Anish-Pun/PXLDIGITAL_GREEN_PROJECT_RESEARCH/Documentation/E220-900T22D.md

### Configuratie E220 (milan)

1. M0 & M1 : 3.3 V / HIGH				      ( Configuration / Sleep mode )
2. Wacht tot AUX uitgang = HIGH 			( E220 niet bezig )
3. Verzend @-command					( UART )
4. Wacht tot AUX = HIGH 			
5. Lees alles wat E220 beantwoordt		( UART )
6. Stap 3 OF exit config M0 & M1 : GND	( Transmission mode )
7. Wacht tot AUX = HIGH
8. Ontvang / Verzend LoRa berichten …

Codevoorbeeld van receiver bevindt zich in: Receiver/reset_config_pi5/config+reset.py
