Anish-Pun/PXLDIGITAL_GREEN_PROJECT_RESEARCH/Afbeeldingen/Sender_Connections.jpg

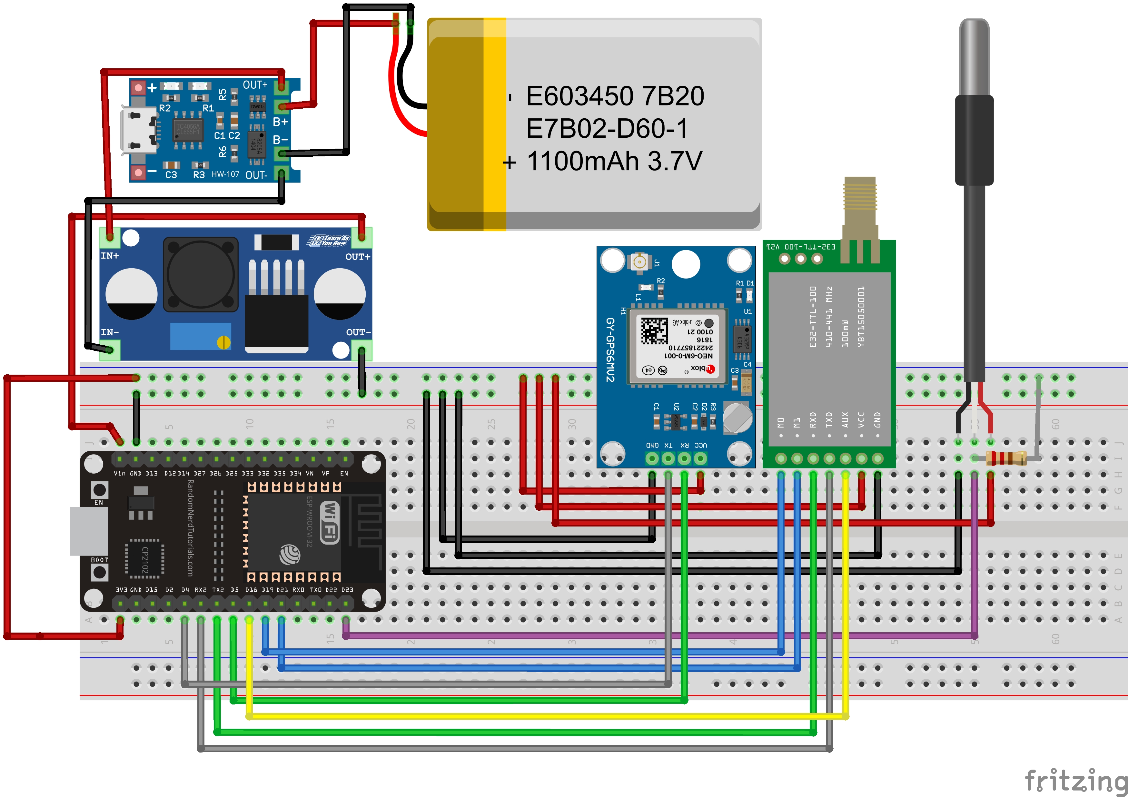
Afbeeldingen/Sender_Connections.jpg
