Anish-Pun/PXLDIGITAL_GREEN_PROJECT_RESEARCH/GPIO's/ESP32_20251021_100118.jpg

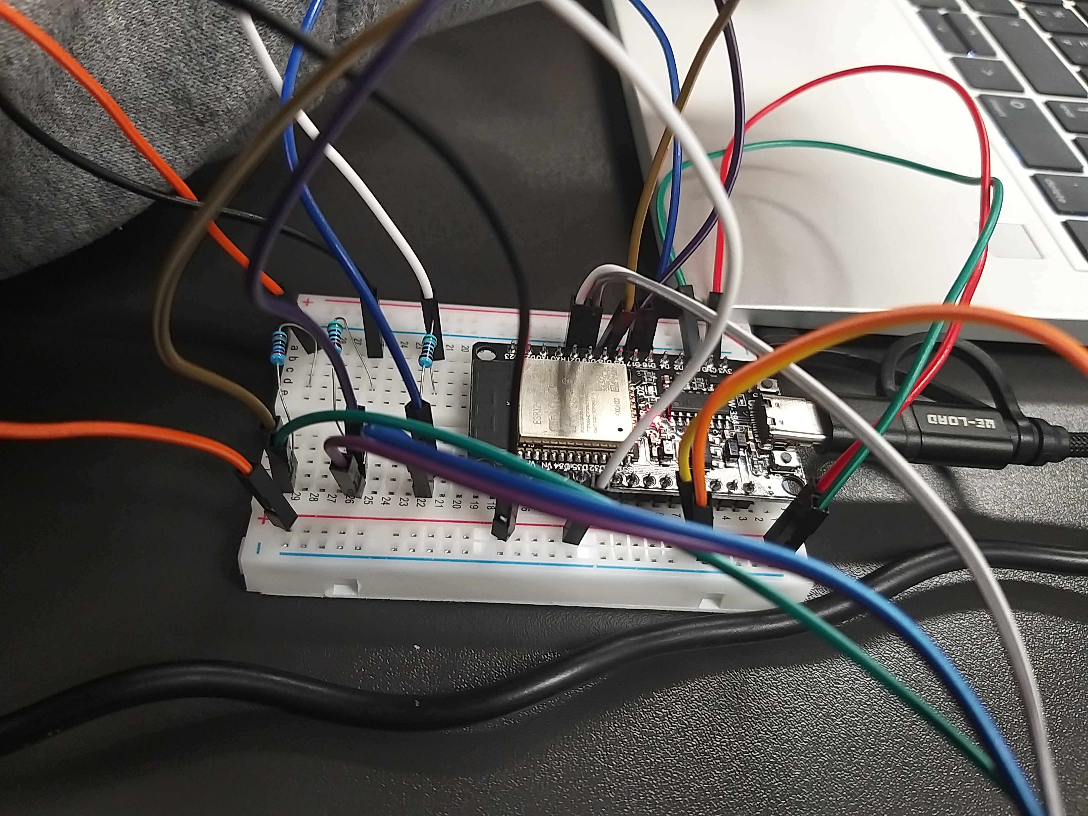
GPIO's/ESP32_20251021_100118.jpg
