Anish-Pun/PXLDIGITAL_GREEN_PROJECT_RESEARCH/GPIO's/gpio-raspberry-pi-4-3-3000036624.png

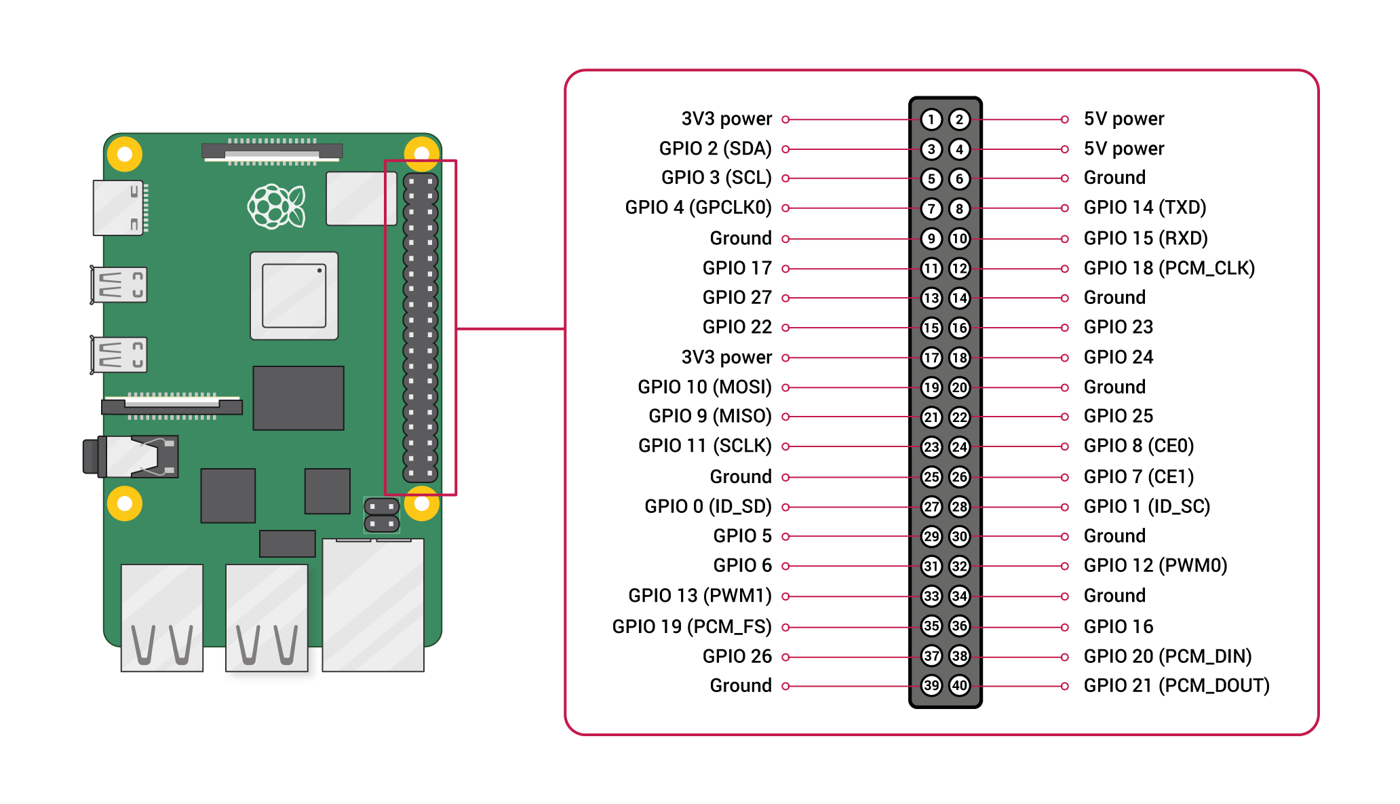
GPIO's/gpio-raspberry-pi-4-3-3000036624.png
