Anish-Pun/PXLDIGITAL_GREEN_PROJECT_RESEARCH/Receiver/reset_config_pi5/20251029_11h25m25s_grim.png

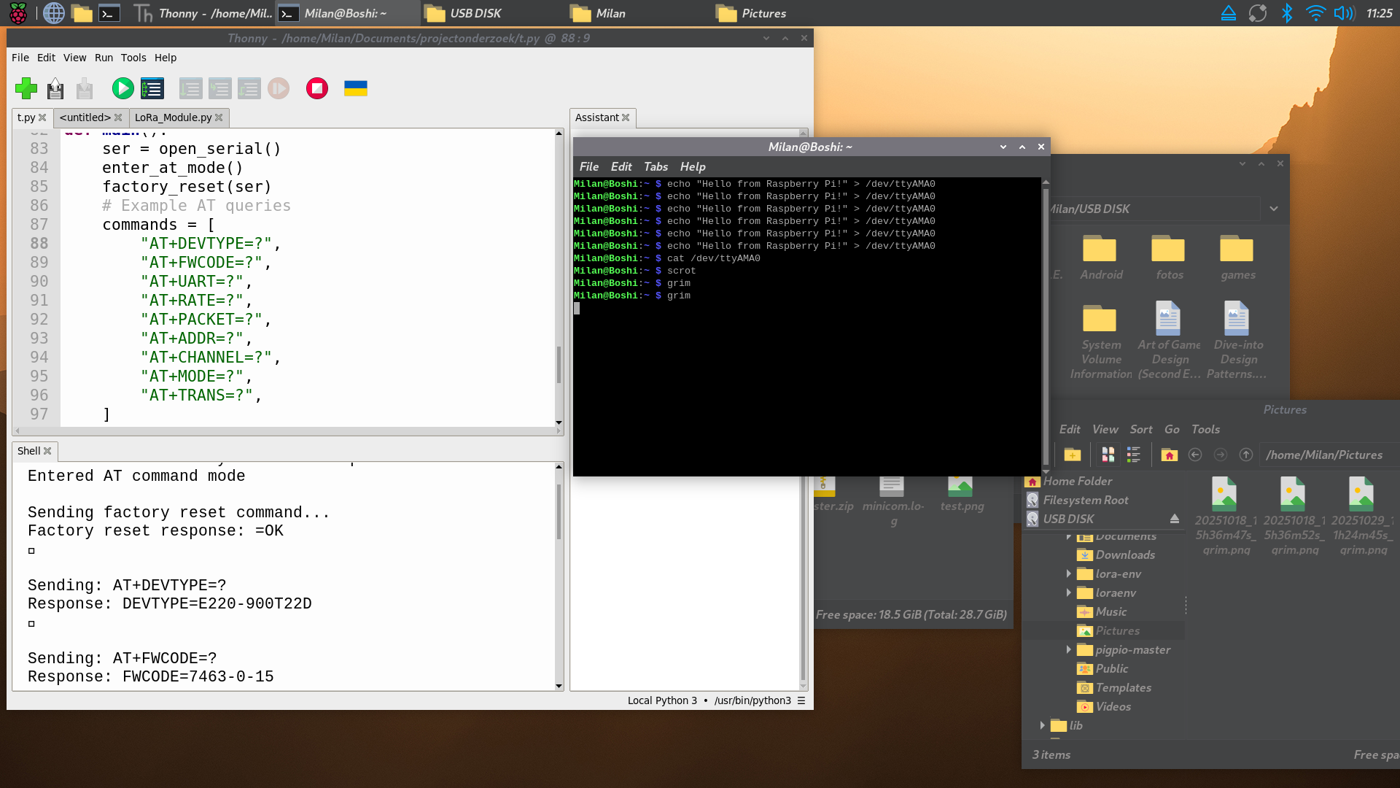
Receiver/reset_config_pi5/20251029_11h25m25s_grim.png
