Anish-Pun/PXLDIGITAL_GREEN_PROJECT_RESEARCH/Receiver/test_NodeRed_UART.png

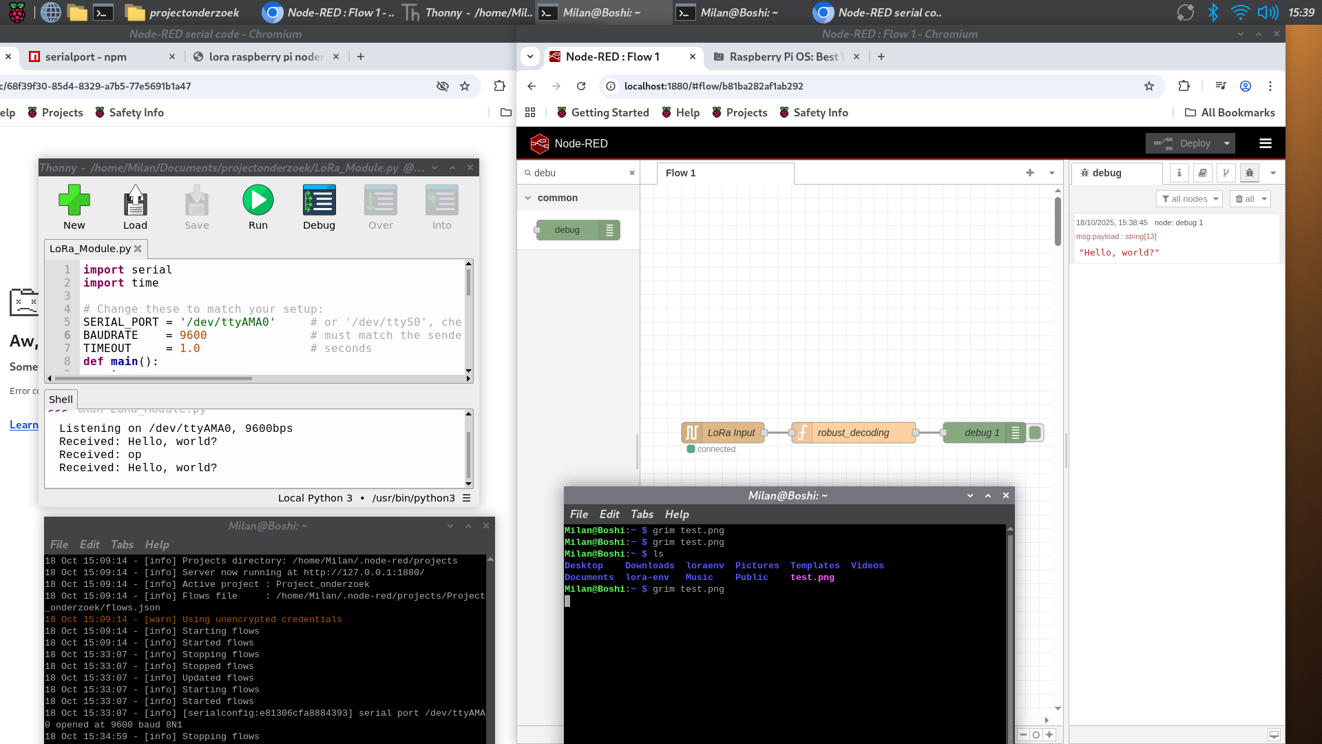
Receiver/test_NodeRed_UART.png
