Anish-Pun/PXLDIGITAL_GREEN_PROJECT_RESEARCH/Sender/Wemos_sendFixedTransmission/Wemos_sendFixedTransmission.ino

/*
 * EBYTE LoRa E220
 * Send a string message to a fixed point ADDH ADDL CHAN
 *
 * You must configure 2 device: one as SENDER (with FIXED SENDER config) and uncomment the relative
 * define with the correct DESTINATION_ADDL, and one as RECEIVER (with FIXED RECEIVER config).
 *
 * E220		  ----- WeMos D1 mini	----- esp32			----- Arduino Nano 33 IoT	----- Arduino MKR	----- Raspberry Pi Pico   ----- stm32               ----- ArduinoUNO
 * M0         ----- D7 (or GND) 	----- 19 (or GND) 	----- 4 (or GND) 			----- 2 (or GND) 	----- 10 (or GND)	      ----- PB0 (or GND)        ----- 7 Volt div (or GND)
 * M1         ----- D6 (or GND) 	----- 21 (or GND) 	----- 6 (or GND) 			----- 4 (or GND) 	----- 11 (or GND)	      ----- PB10 (or GND)       ----- 6 Volt div (or GND)
 * TX         ----- D3 (PullUP)		----- TX2 (PullUP)	----- TX1 (PullUP)			----- 14 (PullUP)	----- 8 (PullUP)	      ----- PA2 TX2 (PullUP)    ----- 4 (PullUP)
 * RX         ----- D4 (PullUP)		----- RX2 (PullUP)	----- RX1 (PullUP)			----- 13 (PullUP)	----- 9 (PullUP)	      ----- PA3 RX2 (PullUP)    ----- 5 Volt div (PullUP)
 * AUX        ----- D5 (PullUP)		----- 18  (PullUP)	----- 2  (PullUP)			----- 0  (PullUP)	----- 2  (PullUP)	      ----- PA0  (PullUP)       ----- 3 (PullUP)
 * VCC        ----- 3.3v/5v			----- 3.3v/5v		----- 3.3v/5v				----- 3.3v/5v		----- 3.3v/5v		      ----- 3.3v/5v             ----- 3.3v/5v
 * GND        ----- GND				----- GND			----- GND					----- GND			----- GND			      ----- GND                 ----- GND
 */

#define E220_22
#define FREQUENCY_868
#define DESTINATION_ADDL 2

// If you want use RSSI uncomment & use relative configuration with RSSI enabled
//#define ENABLE_RSSI true

#include "Arduino.h"
#include "LoRa_E220.h"
#include <SoftwareSerial.h>

// -------- Wemos pins --------
#define PIN_RX D1       // Connect to E220 TX
#define PIN_TX D2       // Connect to E220 RX
#define PIN_AUX D5
#define PIN_M0  D7
#define PIN_M1  D6

SoftwareSerial e220Serial(PIN_RX, PIN_TX);
LoRa_E220 e220ttl(&e220Serial, PIN_AUX, PIN_M0, PIN_M1);

void printParameters(struct Configuration configuration);

void setup() {
	Serial.begin(9600);
	delay(500);
  e220Serial.begin(9600);

	// Startup all pins & UART
	e220ttl.begin();

	ResponseStructContainer c;
	c = e220ttl.getConfiguration();

	// It's important get configuration before all other operation
	Configuration configuration = *(Configuration*) c.data;
	Serial.println(c.status.getResponseDescription());
	Serial.println(c.status.code);
  configuration.ADDL = 0x03;
	configuration.ADDH = 0x00;

	configuration.CHAN = 0x12;

	configuration.SPED.uartBaudRate = UART_BPS_9600;
	configuration.SPED.airDataRate = AIR_DATA_RATE_010_24;
	configuration.SPED.uartParity = MODE_00_8N1;

	configuration.OPTION.subPacketSetting = SPS_200_00;
	configuration.OPTION.RSSIAmbientNoise = RSSI_AMBIENT_NOISE_DISABLED;
	configuration.OPTION.transmissionPower = POWER_22;

	configuration.TRANSMISSION_MODE.enableRSSI = RSSI_DISABLED;
	configuration.TRANSMISSION_MODE.fixedTransmission = FT_FIXED_TRANSMISSION;
	configuration.TRANSMISSION_MODE.enableLBT = LBT_DISABLED;
	configuration.TRANSMISSION_MODE.WORPeriod = WOR_2000_011;

	// Set configuration changed and set to not hold the configuration
	ResponseStatus rs = e220ttl.setConfiguration(configuration, WRITE_CFG_PWR_DWN_SAVE);
	Serial.println(rs.getResponseDescription());
	Serial.println(rs.code);

	c = e220ttl.getConfiguration();
	configuration = *(Configuration*) c.data;
	Serial.println(c.status.getResponseDescription());
	Serial.println(c.status.code);

	printParameters(configuration);
	c.close();

	Serial.print("Hi, I'm going to send message!: ");

	// Send test message
	ResponseStatus rs1 = e220ttl.sendFixedMessage(0, DESTINATION_ADDL, 0x12, "Hello, world?");
	Serial.println(rs1.getResponseDescription());
}
static unsigned long lastSend = 0;
void loop() {
  if (Serial.available()) {
		String input = Serial.readString();
		ResponseStatus rs = e220ttl.sendFixedMessage(0, DESTINATION_ADDL, 0x12, input);
		// Check if unsuccesfully send
		Serial.print(rs.getResponseDescription());
    Serial.print(": ");
    Serial.println(input);
  }
  if (millis() - lastSend > 5000) {  // send every 5s
    lastSend = millis();
    String msg = String(millis()/1000);
    ResponseStatus rs = e220ttl.sendFixedMessage(0, DESTINATION_ADDL, 0x12, msg);
    // Check if unsuccesfully send
		Serial.print(rs.getResponseDescription());
    Serial.print(": ");
    Serial.println(msg);
  }
}


void printParameters(struct Configuration configuration) {
	Serial.println("----------------------------------------");

	Serial.print(F("HEAD : "));  Serial.print(configuration.COMMAND, HEX);Serial.print(" ");Serial.print(configuration.STARTING_ADDRESS, HEX);Serial.print(" ");Serial.println(configuration.LENGHT, HEX);
	Serial.println(F(" "));
	Serial.print(F("AddH : "));  Serial.println(configuration.ADDH, HEX);
	Serial.print(F("AddL : "));  Serial.println(configuration.ADDL, HEX);
	Serial.println(F(" "));
	Serial.print(F("Chan : "));  Serial.print(configuration.CHAN, DEC); Serial.print(" -> "); Serial.println(configuration.getChannelDescription());
	Serial.println(F(" "));
	Serial.print(F("SpeedParityBit     : "));  Serial.print(configuration.SPED.uartParity, BIN);Serial.print(" -> "); Serial.println(configuration.SPED.getUARTParityDescription());
	Serial.print(F("SpeedUARTDatte     : "));  Serial.print(configuration.SPED.uartBaudRate, BIN);Serial.print(" -> "); Serial.println(configuration.SPED.getUARTBaudRateDescription());
	Serial.print(F("SpeedAirDataRate   : "));  Serial.print(configuration.SPED.airDataRate, BIN);Serial.print(" -> "); Serial.println(configuration.SPED.getAirDataRateDescription());
	Serial.println(F(" "));
	Serial.print(F("OptionSubPacketSett: "));  Serial.print(configuration.OPTION.subPacketSetting, BIN);Serial.print(" -> "); Serial.println(configuration.OPTION.getSubPacketSetting());
	Serial.print(F("OptionTranPower    : "));  Serial.print(configuration.OPTION.transmissionPower, BIN);Serial.print(" -> "); Serial.println(configuration.OPTION.getTransmissionPowerDescription());
	Serial.print(F("OptionRSSIAmbientNo: "));  Serial.print(configuration.OPTION.RSSIAmbientNoise, BIN);Serial.print(" -> "); Serial.println(configuration.OPTION.getRSSIAmbientNoiseEnable());
	Serial.println(F(" "));
	Serial.print(F("TransModeWORPeriod : "));  Serial.print(configuration.TRANSMISSION_MODE.WORPeriod, BIN);Serial.print(" -> "); Serial.println(configuration.TRANSMISSION_MODE.getWORPeriodByParamsDescription());
	Serial.print(F("TransModeEnableLBT : "));  Serial.print(configuration.TRANSMISSION_MODE.enableLBT, BIN);Serial.print(" -> "); Serial.println(configuration.TRANSMISSION_MODE.getLBTEnableByteDescription());
	Serial.print(F("TransModeEnableRSSI: "));  Serial.print(configuration.TRANSMISSION_MODE.enableRSSI, BIN);Serial.print(" -> "); Serial.println(configuration.TRANSMISSION_MODE.getRSSIEnableByteDescription());
	Serial.print(F("TransModeFixedTrans: "));  Serial.print(configuration.TRANSMISSION_MODE.fixedTransmission, BIN);Serial.print(" -> "); Serial.println(configuration.TRANSMISSION_MODE.getFixedTransmissionDescription());

	Serial.println("----------------------------------------");
}
