Anish-Pun/PXLDIGITAL_GREEN_PROJECT_RESEARCH/(commit log)

2025-10-21 Create flows.json
    Basic LoRa Communication flow in Node-RED
2025-10-28 test fixed comm uno -> esp32
    [01_setConfiguration.ino, ESP32_sendFixedTransmission.ino, UNO_sendFixedTransmission.ino]
2025-10-29 pi config & factory reset
    [config+reset.py]
2025-11-02 Added power saving mode
    Added ESP sleep, now saving ~70% of energy. Next, we need to implement LoRa sleep mode.
2025-11-04 Update BasicSender.cpp
    Updated GPS TX pin.
2025-11-13 Sender & receiver examples for fixed LoRa E220 transmission
    example to test lora signal range,...
    [ESP32_receiveFixedTransmission.ino, Wemos_sendFixedTransmission.ino]
2025-11-17 Added DS18B20 temperature sensor support and included readings
    Integrated DS18B20 temperature sensor
    Initialized sensor in setup()
    Read temperature in loop()
    Added temperature to JSON payload sent via LoRa
2025-11-18 Afbeelding folder toegevoegt voor de afbeeldingen in de readme file. Readme geupdatet met bevindigen, gpios en errormeldinge
2025-11-22 Update VCC voltage range in README
2025-11-22 Add image for GPIO Raspberry Pi pinout
2025-11-22 Added LDR day/night sensor
2025-11-23 Update Wemos_sendFixedTransmission.ino
    test fixed with millis()/1000
    [Wemos_sendFixedTransmission.ino]
2025-11-25 Update README.md
    UART controle
2025-11-25 Uploaded Node-Red Flow
2025-12-01 Cleanup code test fixed
    [ESP32_receiveFixedTransmission.ino, Wemos_sendFixedTransmission.ino]
2025-12-02 updated readme to show schematic with LDR
2025-12-07 toevoeging .md voor sensoren & lora module
2025-12-07 Remove E220 configuration and UART control details
    Removed configuration steps for E220 and UART control instructions.
2025-12-07 Update UART section for Raspberry Pi 5 documentation
2025-12-07 Revise README for Raspberry Pi GPIO section
    Updated references and notes for Raspberry Pi setup.
2025-12-07 Enhance documentation for Raspberry Pi 5 GPIO setup
    Added detailed GPIO pinout information for the Raspberry Pi 5 and included an image reference.
2025-12-07 Update README with revised product assembly details
    Revised the description of the end product assembly and housing requirements.
2025-12-15 Update AUX pin description in README.md
2025-12-15 Revise GPIO table and add example code for LoRa E220
    Updated GPIO table for LoRa E220 with Wemos D1 Mini Pro pin mappings and added example code section.
2025-12-15 Revise GPIO section and update title in documentation
    Updated the document to clarify GPIO pin assignments and changed the section title for better accuracy.
2025-12-15 Updated schematic for Sender
